ndf-zz/syncbox/README.md

# syncbox

MIDI/USB to DIN sync converter

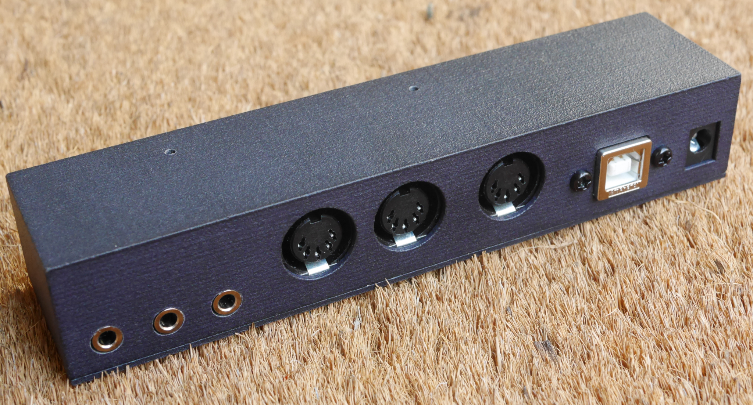
[picture p1: prototype.jpg]
Prototype


[work in progress]

## Contents

   - pcb: Kicad schematic and circuit board
   - enclosure: FreeCAD enclosure
   - firmware: STM32 firmware
   - syncbox-edit: Python SysEx configuration editor
