ndf-zz/syncbox/pcb/syncbox_prototype.jpg

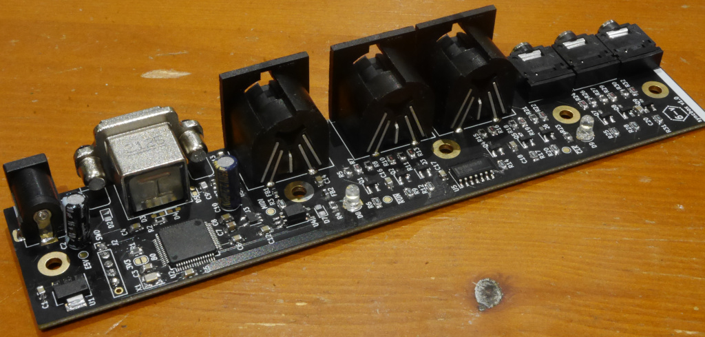
pcb/syncbox_prototype.jpg
