ndf-zz/syncbox/enclosure/syncbox_enclosure_top.stl

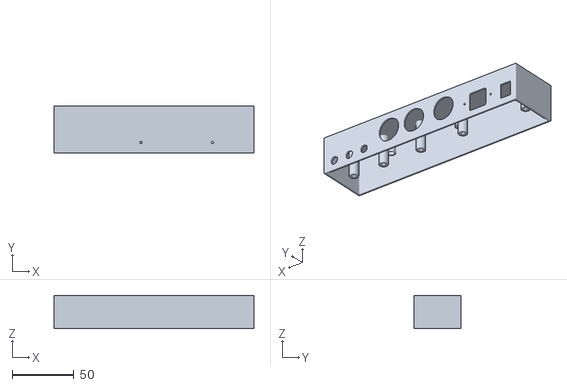
[picture p3: CAD file, 2024-04-12]
enclosure/syncbox_enclosure_top.stl
162.0 x 38.0 x 27.1
