ndf-zz/syncbox/enclosure/syncbox_enclosure_base.stl

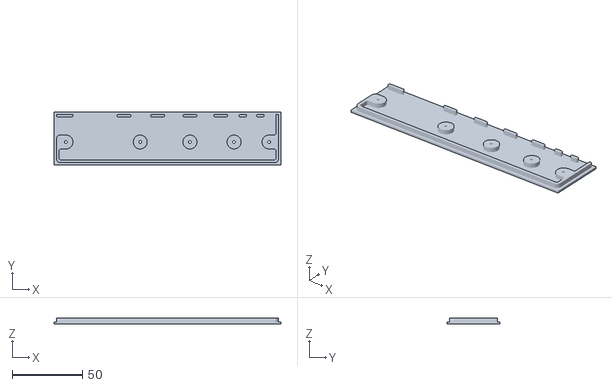
[picture p4: CAD file, 2024-04-12]
enclosure/syncbox_enclosure_base.stl
162.0 x 38.0 x 4.50
