ndf-zz/syncbox/(list of files, cad)

Other CAD files:
enclosure/syncbox_enclosure.FCStd
