ndf-zz/syncbox/pcb/syncbox_schematic.pdf

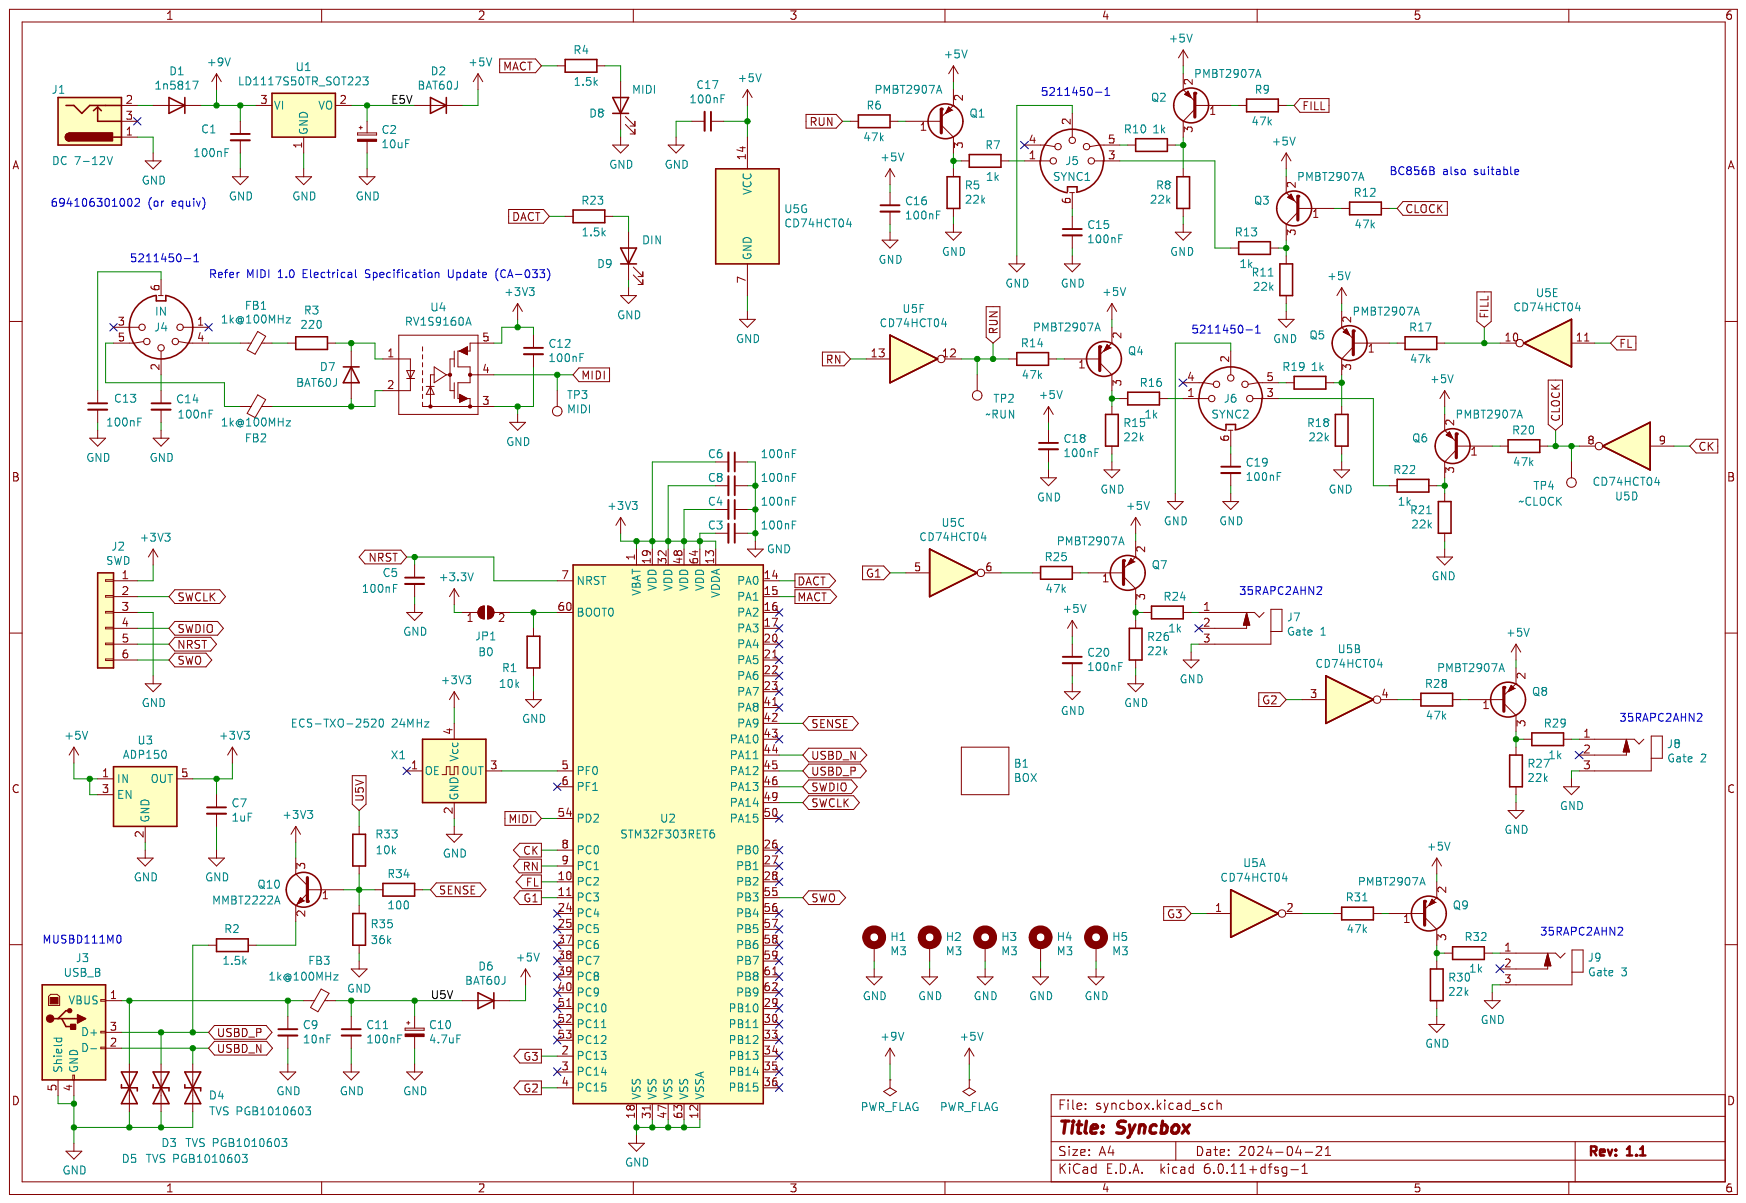
[picture p5: page 1]
