ndf-zz/syncbox/pcb/syncbox.kicad_pcb

## KiCad design pcb/syncbox.kicad_pcb (2024-04-22)

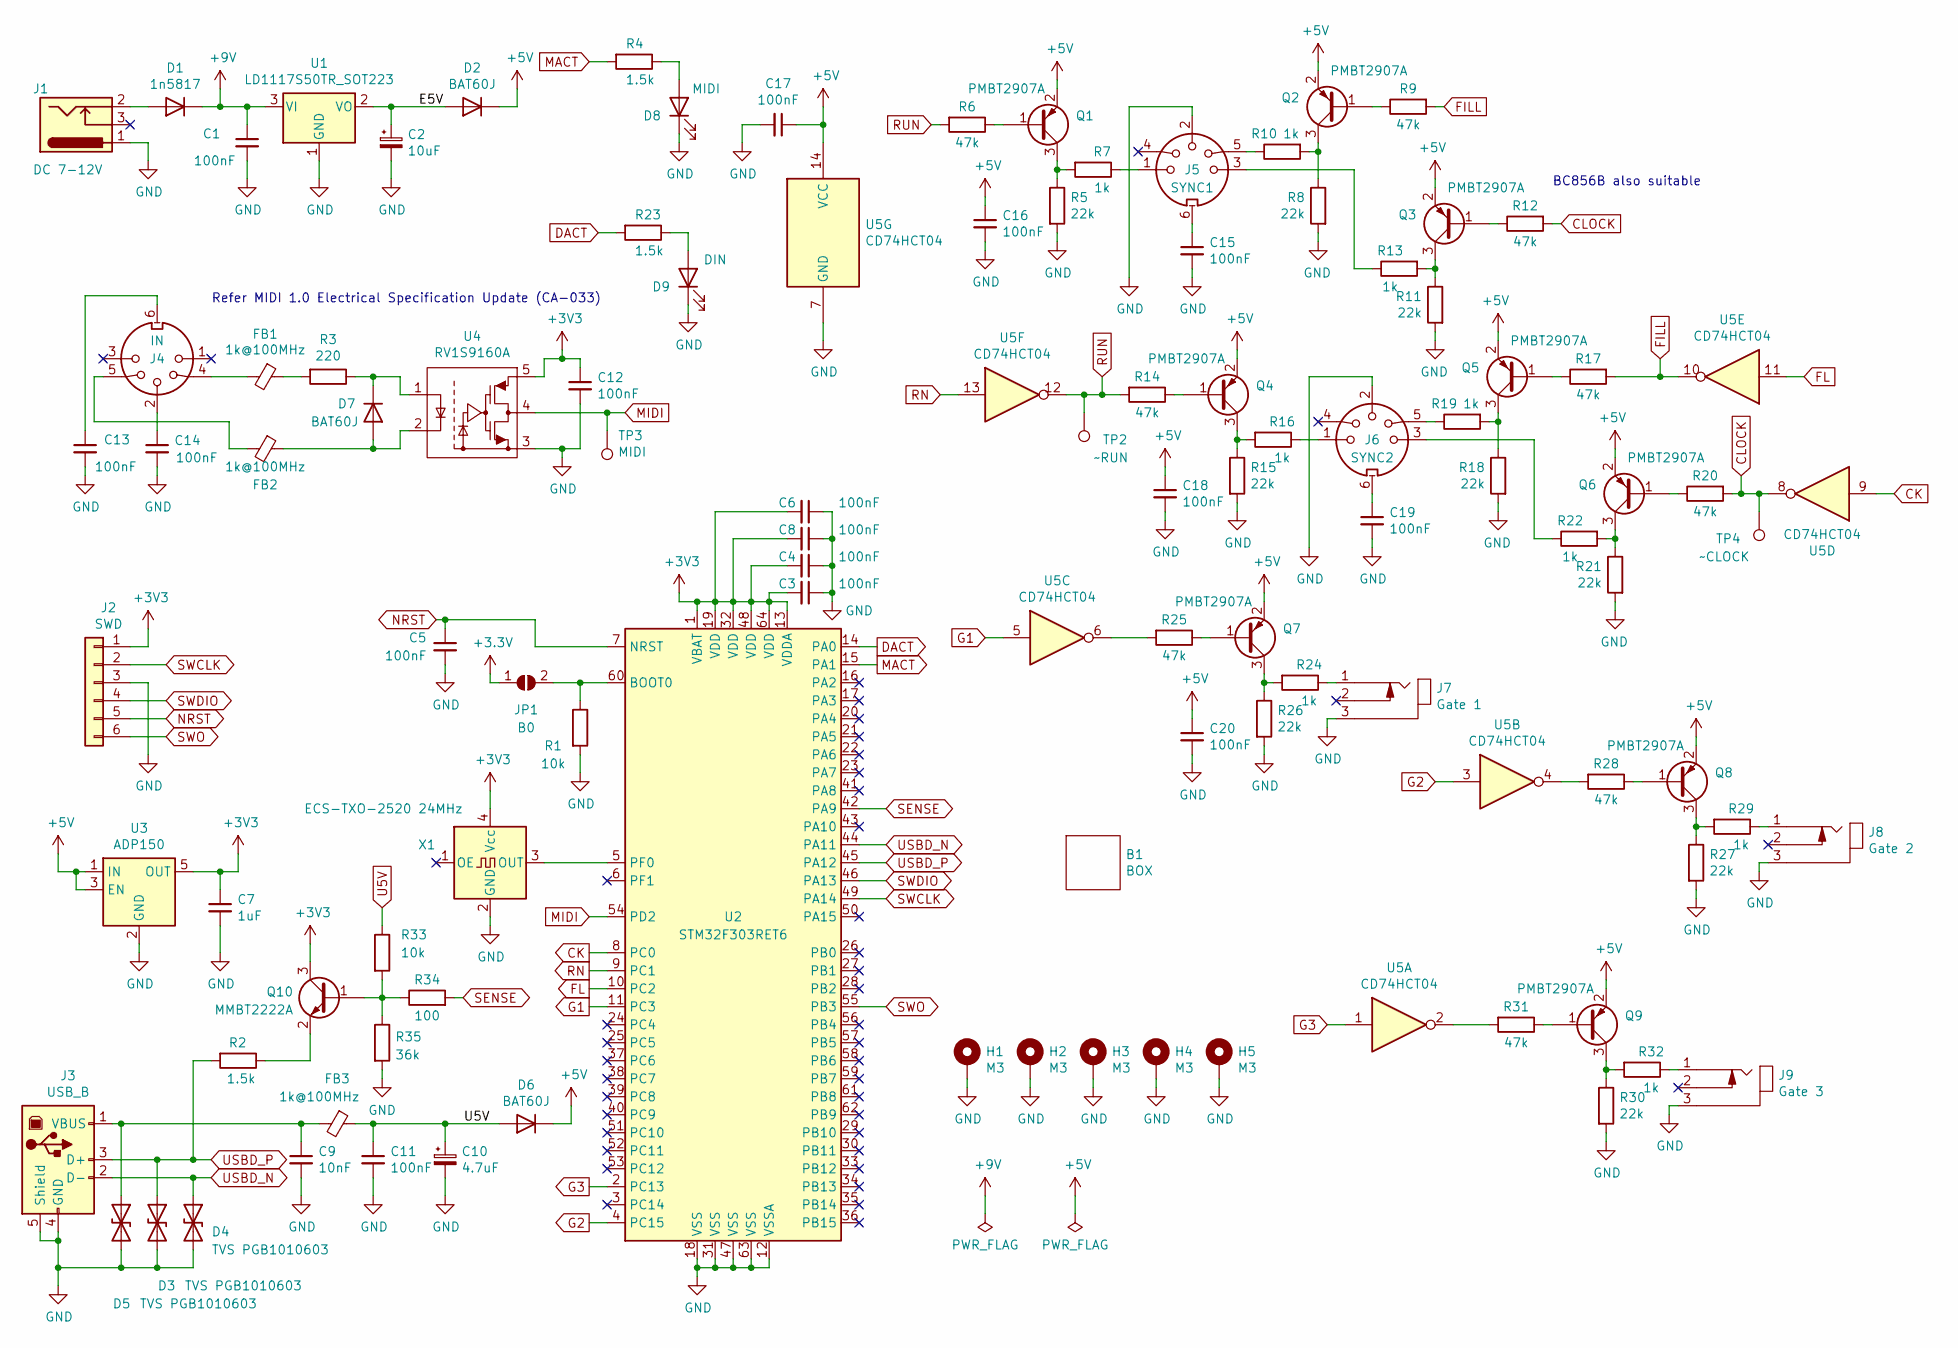
[picture p6: schematic syncbox.kicad_sch]

Parts:
B1: BOX
C1, C3, C4, C5, C6, C8, C11, C12, C13, C14, C15, C16, C17, C18, C19, C20: 100nF; C_0805_2012Metric_Pad1.15x1.40mm_HandSolder
C2: 10uF; CP_Radial_D4.0mm_P2.00mm
C7: 1uF; C_0805_2012Metric_Pad1.15x1.40mm_HandSolder
C9: 10nF; C_0805_2012Metric_Pad1.15x1.40mm_HandSolder
C10: 4.7uF; CP_Radial_D4.0mm_P2.00mm
D1: 1n5817; D_A-405_P10.16mm_Horizontal
D2, D6, D7: BAT60J; D_SOD-323_HandSoldering
D3, D4, D5: TVS PGB1010603; D_0603_1608Metric_Pad1.05x0.95mm_HandSolder
D8: MIDI; LED_D3.0mm_Clear
D9: DIN; LED_D3.0mm_Clear
FB1, FB2, FB3: 1k@100MHz; L_0603_1608Metric_Pad1.05x0.95mm_HandSolder
H1, H2, H3, H4, H5: M3; MountingHole_3.2mm_M3_Pad
J1: DC 7-12V; BarrelJack_Horizontal
J2: SWD; PinHeader_1x06_P2.54mm_Vertical
J3: USB_B; MUSBD111M0
J4: IN; 5211450-1
J5: SYNC1; 5211450-1
J6: SYNC2; 5211450-1
J7: Gate 1; 35RAPC2AHN2
J8: Gate 2; 35RAPC2AHN2
J9: Gate 3; 35RAPC2AHN2
JP1: B0; SolderJumper-2_P1.3mm_Open_RoundedPad1.0x1.5mm
Q1, Q2, Q3, Q4, Q5, Q6, Q7, Q8, Q9: PMBT2907A; SOT-23_Handsoldering
Q10: MMBT2222A; SOT-23_Handsoldering
R1: 10k; R_0805_2012Metric_Pad1.15x1.40mm_HandSolder
R2, R4, R23: 1.5k; R_0805_2012Metric_Pad1.15x1.40mm_HandSolder
R3: 220; R_0805_2012Metric_Pad1.15x1.40mm_HandSolder
R5, R8, R11, R15, R18, R21, R26, R27, R30: 22k; R_0805_2012Metric_Pad1.15x1.40mm_HandSolder
R6, R9, R12, R14, R17, R20, R25, R28, R31: 47k; R_0805_2012Metric_Pad1.15x1.40mm_HandSolder
R7, R10, R13, R16, R19, R22, R24, R29, R32: 1k; R_0805_2012Metric_Pad1.15x1.40mm_HandSolder
R33: 10k; R_0805_2012Metric_Pad1.20x1.40mm_HandSolder
R34: 100; R_0805_2012Metric_Pad1.20x1.40mm_HandSolder
R35: 36k; R_0805_2012Metric_Pad1.20x1.40mm_HandSolder
TP2: ~RUN; TestPoint_Pad_D1.5mm
TP3: MIDI; TestPoint_Pad_D1.5mm
TP4: ~CLOCK; TestPoint_Pad_D1.5mm
U1: LD1117S50TR_SOT223; SOT-223-3_TabPin2
U2: STM32F303RET6; LQFP-64_10x10mm_P0.5mm; LCSC C183214
U3: ADP150; SOT-23-5_HandSoldering
U4: RV1S9160A; SO-5_4.4x3.6mm_P1.27mm
U5: CD74HCT04; SOIC-14_3.9x8.7mm_P1.27mm
X1: ECS-TXO-2520 24MHz; Oscillator_SMD_SeikoEpson_SG210-4Pin_2.5x2.0mm_HandSoldering

Connections:
+5V: C16.1, C17.1, C18.1, C20.1, D2.1 (K), D6.1 (K), Q1.2 (E), Q2.2 (E), Q3.2 (E), Q4.2 (E), Q5.2 (E), Q6.2 (E), Q7.2 (E), Q8.2 (E), Q9.2 (E), U3.1 (IN), U3.3 (EN), U5.14 (VCC)
+9V: C1.1, D1.1 (K), U1.3 (VI)
/E5V: C2.1, D2.2 (A), U1.2 (VO)
CK: U2.8 (PC0), U5.9
CLOCK: R12.2, R20.2, TP4.1, U5.8
DACT: R23.2, U2.14 (PA0)
FILL: R9.2, R17.2, U5.10
FL: U2.10 (PC2), U5.11
G1: U2.11 (PC3), U5.5
G2: U2.4 (PC15), U5.3
G3: U2.2 (PC13), U5.1
GND: C1.2, C2.2, C3.1, C4.1, C5.2, C6.1, C7.2, C8.1, C9.2, C10.2, C11.2, C12.2, C13.2, C14.2, C15.2, C16.2, C17.2, C18.2, C19.2, C20.2, D3.2 (A2), D4.2 (A2), D5.2 (A2), D8.1 (K), D9.1 (K), H1.1, H2.1, H3.1, H4.1, H5.1, J1.1, J2.3, J3.4 (GND), J3.5 (Shield), J5.2, J6.2, J7.3, J8.3, J9.3, R1.2, R5.2, R8.2, R11.2, R15.2, R18.2, R21.2, R26.2, R27.2, R30.2, R35.2, U1.1 (GND), U2.12 (VSSA), U2.18 (VSS), U2.31 (VSS), U2.47 (VSS), U2.63 (VSS), U3.2 (GND), U4.3, U5.7 (GND), X1.2 (GND)
MACT: R4.2, U2.15 (PA1)
MIDI: TP3.1, U2.54 (PD2), U4.4
NRST: C5.1, J2.5, U2.7 (NRST)
unnamed: C9.1, D5.1 (A1), FB3.2, J3.1 (VBUS)
unnamed: C13.1, J4.6
unnamed: C14.1, J4.2
unnamed: C15.1, J5.6
unnamed: C19.1, J6.6
unnamed: D1.2 (A), J1.2
unnamed: D7.1 (K), R3.1, U4.1
unnamed: D7.2 (A), FB2.1, U4.2
unnamed: D8.2 (A), R4.1
unnamed: D9.2 (A), R23.1
unnamed: FB1.1, R3.2
unnamed: FB1.2, J4.4
unnamed: FB2.2, J4.5
unnamed: J5.1, R7.1
unnamed: J5.3, R13.1
unnamed: J5.5, R10.1
unnamed: J6.1, R16.1
unnamed: J6.3, R22.1
unnamed: J6.5, R19.1
unnamed: J7.1, R24.1
unnamed: J8.1, R29.1
unnamed: J9.1, R32.1
unnamed: JP1.2 (B), R1.1, U2.60 (BOOT0)
unnamed: Q1.1 (B), R6.1
unnamed: Q1.3 (C), R5.1, R7.2
unnamed: Q2.1 (B), R9.1
unnamed: Q2.3 (C), R8.1, R10.2
unnamed: Q3.1 (B), R12.1
unnamed: Q3.3 (C), R11.1, R13.2
unnamed: Q4.1 (B), R14.1
unnamed: Q4.3 (C), R15.1, R16.2
unnamed: Q5.1 (B), R17.1
unnamed: Q5.3 (C), R18.1, R19.2
unnamed: Q6.1 (B), R20.1
unnamed: Q6.3 (C), R21.1, R22.2
unnamed: Q7.1 (B), R25.1
unnamed: Q7.3 (C), R24.2, R26.1
unnamed: Q8.1 (B), R28.1
unnamed: Q8.3 (C), R27.1, R29.2
unnamed: Q9.1 (B), R31.1
unnamed: Q9.3 (C), R30.1, R32.2
unnamed: Q10.1 (B), R33.2, R34.1, R35.1
unnamed: Q10.2 (E), R2.1
unnamed: R25.2, U5.6
unnamed: R28.2, U5.4
unnamed: R31.2, U5.2
unnamed: U2.5 (PF0), X1.3 (OUT)
RN: U2.9 (PC1), U5.13
RUN: R6.2, R14.2, TP2.1, U5.12
SENSE: R34.2, U2.42 (PA9)
SWCLK: J2.2, U2.49 (PA14)
SWDIO: J2.4, U2.46 (PA13)
SWO: J2.6, U2.55 (PB3)
U5V: C10.1, C11.1, D6.2 (A), FB3.1, R33.1
USBD_N: D4.1 (A1), J3.2 (D-), U2.44 (PA11)
USBD_P: D3.1 (A1), J3.3 (D+), R2.2, U2.45 (PA12)

Notes on the sheet:
Refer MIDI 1.0 Electrical Specification Update (CA-033)
BC856B also suitable

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
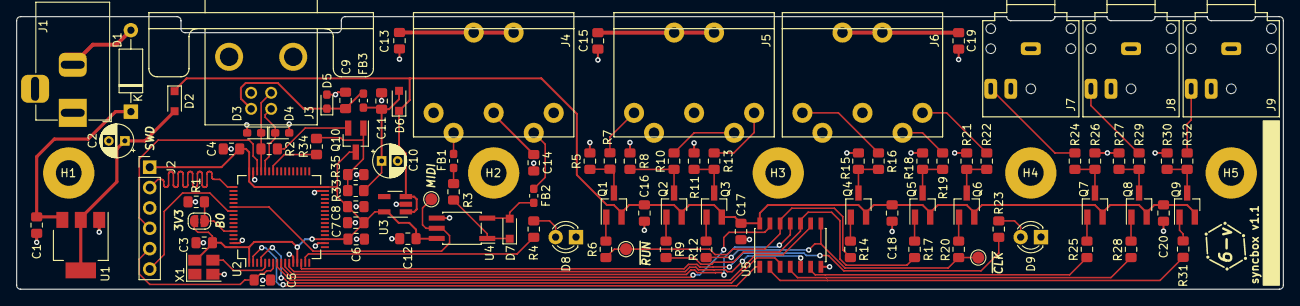
[picture p7: board syncbox.kicad_pcb from above]

Board: 2 copper layers, 158.0 x 34.0 mm, 102 parts (0 on the bottom side), 72 nets.
