ndf-zz/syncbox/firmware/include/midi_usb.h

// SPDX-License-Identifier: MIT

/*
 * MIDI USB Device Interface
 */
#ifndef MIDI_USB_H
#define MIDI_USB_H
#include <stdint.h>

// Initialise hardware and enable interrupt
void midi_usb_init(void);

#endif /* MIDI_USB_H */
