ndf-zz/syncbox/(commit log)

2024-04-12 Add cad files to ignore
2024-04-12 Add CAD files
    [syncbox.kicad_pcb, syncbox.kicad_sch, syncbox_enclosure.FCStd, syncbox_enclosure_base.stl, syncbox_enclosure_top.stl]
2024-04-12 Add prototype photo
2024-04-12 Add preliminary hardware test
    [f303re_pins.ods]
2024-04-16 Update ST device header to V2.3.5
2024-04-22 Add led display code
2024-04-22 Update pin assignment document
    [f303re_pins.ods]
2024-04-22 Version 1.1 hardware changes
    [syncbox.kicad_pcb, syncbox.kicad_sch]
2024-04-24 Update MIDI UART and event interfaces
2024-04-26 Enable SWO output pin
2024-04-27 Update schematic and top label
    [syncbox.kicad_sch]
2024-05-02 Fix rom/build mismatch sysex error
    [main.c]
2024-05-02 Add SWO trace script
2024-05-03 Add crude timer and improve output handling
2024-05-08 Adjust uptime counter to 1/8ms and add conditional trace
2024-05-08 Fix timer offset logic
    [main.c, timer.c, timer.h]
2024-05-08 Start midi-usb device
